lengoctuong2005/cpu4-custom-architecture/Thiết-kế-vi-mạch-điện-tử-Exercises.pdf

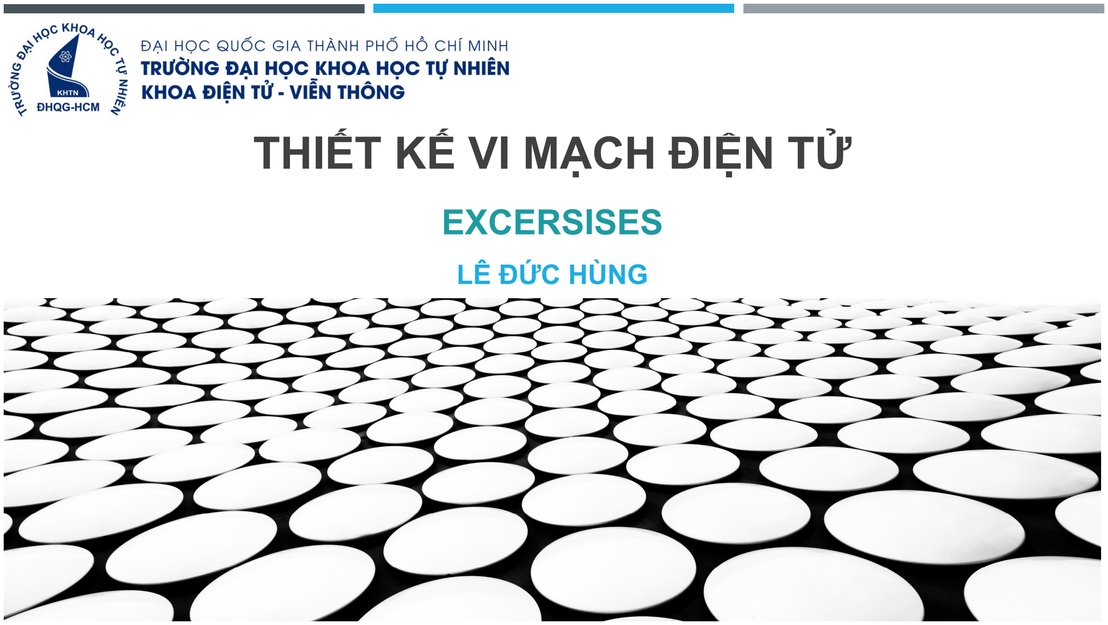
[picture p1: page 1]

# THIẾT KẾ VI MẠCH ĐIỆN TỬ

### LÊ ĐỨC HÙNG

## EXCERSISES

## EXERCISES

1. Find xp, xn, xd, ψ0, Cj0, Cj for an applied voltage of -4V of a pn diode with a step junction, NA = 5x10¹⁵/cm³, ND = 10²⁰/cm³, and an area of 10µm by 10µm.
2. NA = 5x10¹⁵/cm³, ND = 10²⁰/cm³, DN = 20cm²/s, DP = 10cm²/s, LN = 10µm, LP = 5µm, A = 10µm². Calculate the saturation current of pn junction.
3. Using LTSPICE, sketch ID-VDS characteristic of NMOS and PMOS (VGS steps from 1V, 2V, 3V, 4V, 5V) for each following transistor sizes: W/L = 10µm/10µm, W/L = 10µm/1µm, W/L = 1µm/10µm, W/L = 1µm/1µm.
4. Using LTSPICE, sketch ID-VGS characteristic of NMOS and PMOS (VDS steps from 1V, 2V, 3V, 4V, 5V) for each following transistor sizes: W/L = 10µm/10µm, W/L = 10µm/1µm, W/L = 1µm/10µm, W/L = 1µm/1µm.
5. Using LTSPICE, sketch RON-VGS characteristic of NMOS and PMOS with the following transistor sizes: W/L = 50µm/1µm, W/L = 10µm/1µm, W/L = 5µm/1µm, W/L = 1µm/1µm.

2

## EXERCISES

6. Consider an NMOS process technology for which Lmin = 0.4mm, tox = 8nm, mn = 450cm²/Vs, Vt = 0.7V.
a) Find Cox and k’

n.
b) For a MOSFET with W/L = 8mm/0.8mm, calculate the values of vOV, vGS, and vDSmin needed to operate the transistor in the saturation region with dc current ID = 100mA.
c) For the device in (b), find the values of vOV and vGS required to cause the device to operate as a 1kΩ resistor for very small vDS.
7. Consider an NMOS transistor fabricated in an 0.18µm process with L = 0.18µm and W = 2µm. The process technology is specified to have Cox = 8.6fF/µm², mn = 450cm²/Vs, and Vtn = 0.5V.
a) Find VGS and VDS that result in the MOSFET operating at the edge of saturation with ID = 100µA.
b) If VGS is kept constant, find VDS that results in ID = 50µA.
c) To investigate the use of the MOSFET as a linear amplifier, let it be operating in saturation with VDS = 0.3V. Find the change in i

D resulting from vGS changing from 0.7V by +0.01V and -0.01V.

3

## EXERCISES

8. An inverter is designed with (W/L)n = 10 and (W/L)p = 16, which is fabricated in a process where K’n = 110µA/V², VT0n = 0.7V, K’p = 50µA/V², VT0p = -0.7V.
a) Calculate the middle point voltage of the inverter VI

, VIH, VIL. Make sure that VIL < VI < VIH. Use LTSPICE to sketch Vin-Vout function waveform, and Voltage Transfer Characteristic (VTC) curve.
b) Adjust (W/L)n and (W/L)p so that the the middle point voltage is at the center of VTC. Use LTSPICE to sketch Vin-Vout function waveform, and Voltage Transfer Characteristic (VTC) curve.

### 9. Calculate the middle point voltage VI

, of NAND-2 and NOR-2 with (W/L)n = 5 and (W/L)p = 8, which is fabricated in a process where K’n = 110µA/V², VT0n = 0.7V, K’p = 50µA/V², VT0p = -0.7V. Use LTSPICE to sketch Voltage Transfer Characteristic (VTC) curve of NAND2 and NOR2.

4

## EXERCISES

10. Calculation all of the inverter characteristics with the information provided.

5

PMOS Parameters | NMOS Parameters
L = 1µm, W = 7µm | L = 1µm, W = 5µm
Tn = 0.7V, K’n = 110µA/V² | VTp = -0.8V, K’ V p= 50µA/V²
| Cj0 = 4.85x10⁻⁸F/cm² Cj0 = 2.82x10⁻⁸F/cm², φo = 0.9V , φo = 0.92V
| Cjsw = 1.95x10 Cjsw = 4.62x10⁻¹²F/cm, φosw = 0.95V -12F/cm, φosw = 0.97V
Oxide thickness: tox = 150 Amstrong Gate overlap: L0 = 0.05µm
Power supply: VDD = 5V
Fanout number: FO = 3

## EXERCISES

11. Calculation of setup time and hold time. Are there any violations of Setup time and Hold time?

6

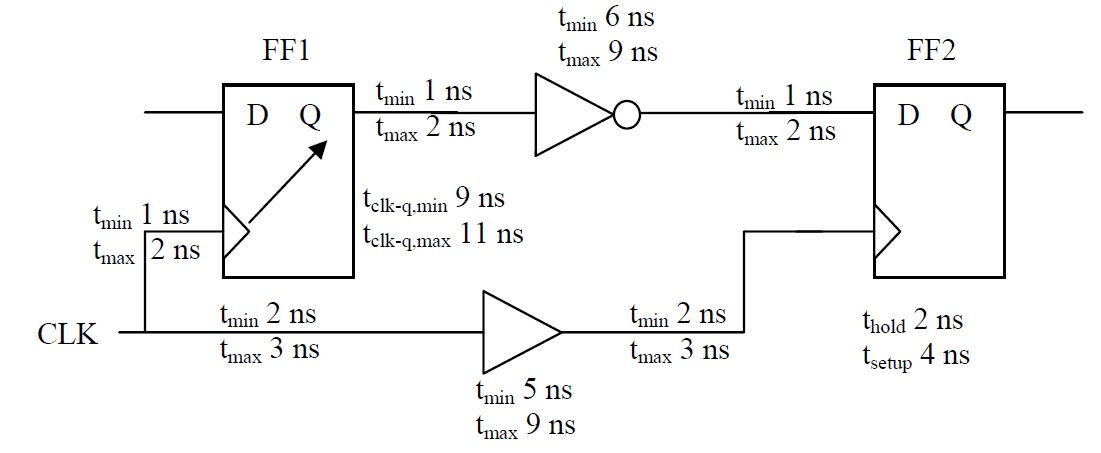
[picture p2: figure]
