lengoctuong2005/cpu4-custom-architecture/docs/CPU_4Bit_Presentation.pptx

THIẾT KẾ CPU 4-BIT

Dùng Quy trình Thiết kế Mạch số (RTL Flow)

Báo cáo Đồ án Môn học: Thiết kế Vi mạch Điện tử
Đề tài số 7 — Mô phỏng kiểm thử RTL (Verilog)

## Slide 2

1. Tổng quan Kiến trúc CPU 4-bit

Đặc tả Kiến trúc (Specifications):

• Kiến trúc Harvard: ROM (Chỉ lệnh) & RAM (Dữ liệu) tách biệt.
• Chu kỳ Đơn (Single-cycle): Mỗi lệnh thực thi hoàn tất trong đúng 1 chu kỳ xung clock.
• Lõi dữ liệu 4-bit: Độ rộng thanh ghi, ALU và RAM dữ liệu là 4-bit.
• Từ lệnh 8-bit: Opcode 4-bit + Toán hạng 4-bit.
• Tập thanh ghi: 4 thanh ghi đa năng R0–R3 (4-bit). R0 dùng làm accumulator cho LOAD/STORE.

Mô hình Lập trình & Tài nguyên:

• Program Counter (PC): 4-bit, trỏ đến 16 địa chỉ ô nhớ ROM.

• Bộ nhớ ROM chỉ lệnh: Kích thước 16 x 8-bit.

• Bộ nhớ RAM dữ liệu: Kích thước 16 x 4-bit.

• Các cờ trạng thái ALU: Cờ Zero (Z) báo kết quả bằng 0; cờ Negative (N) báo kết quả âm.

## Slide 3

2. Tập lệnh (Instruction Set Architecture - ISA)

Từ lệnh 8-bit được chia thành: Opcode [7:4] (4-bit) và Operand [3:0] (4-bit).

Lệnh | Mã máy (Bin) | Toán hạng | Mô tả chức năng
LOAD addr | 0001 | addr (4-bit) | Nạp giá trị từ RAM[addr] vào thanh ghi tích lũy R0
STORE addr | 0010 | addr (4-bit) | Lưu giá trị từ thanh ghi R0 vào RAM[addr]
ADD Rd, Rs | 0011 | Rd (2-bit), Rs (2-bit) | Cộng thanh ghi: R[Rd] = R[Rd] + R[Rs]
SUB Rd, Rs | 0100 | Rd (2-bit), Rs (2-bit) | Trừ thanh ghi: R[Rd] = R[Rd] - R[Rs]
MOV Rd, Rs | 0101 | Rd (2-bit), Rs (2-bit) | Copy dữ liệu: R[Rd] = R[Rs]
JMP addr | 0110 | addr (4-bit) | Nhảy không điều kiện: PC = addr
JZ addr | 0111 | addr (4-bit) | Nhảy nếu cờ Zero bật (Z=1): PC = addr
OUT Rs | 1000 | Rs (2-bit) | Xuất giá trị của thanh ghi Rs ra cổng OUT
HALT | 1111 | Không có | Dừng chương trình (đóng băng PC)

## Slide 4

3. Thiết kế Datapath (Đường đi dữ liệu)

Program Counter

Trỏ địa chỉ lệnh (4-bit)

Instruction ROM

Chứa chương trình (8-bit)

Register File

4 thanh ghi R0-R3 (4-bit)

ALU 4-bit

Cộng, trừ & tính cờ Z, N

Data Memory

RAM lưu dữ liệu (16x4)

Cổng OUT

Mạch thiết kế theo mô hình Single-cycle: trong 1 chu kỳ xung clock, lệnh được nạp từ ROM, giải mã tại Control Unit, đọc dữ liệu từ thanh ghi, tính toán qua ALU, ghi ngược lại thanh ghi hoặc RAM, và PC tăng lên 1.

## Slide 5

4. Khối điều khiển (Control Unit)

Lệnh | RegWr | ALUSrc | ALUOp | MemRd | MemWr | MemToReg
LOAD | 1 | 1 (Mem) | 000 (Pass) | 1 | 0 | 1 (Mem)
STORE | 0 | 1 (Mem) | 000 (Pass) | 0 | 1 | x
ADD | 1 | 0 (Reg) | 001 (Add) | 0 | 0 | 0 (ALU)
SUB | 1 | 0 (Reg) | 010 (Sub) | 0 | 0 | 0 (ALU)
MOV | 1 | 0 (Reg) | 011 (Mov) | 0 | 0 | 0 (ALU)
JMP / JZ | 0 | x | xxx | 0 | 0 | x
OUT | 0 | 0 | 011 (Pass) | 0 | 0 | x

Nhiệm vụ của CU:

• Giải mã Opcode: Nhận 4 bit cao của lệnh [7:4] đưa vào mạch giải mã tổ hợp.

• Sinh tín hiệu điều khiển: Sinh các tín hiệu chọn đường multiplexer, cho phép ghi RAM (mem_write), ghi thanh ghi (reg_write).

• Điều khiển rẽ nhánh: Phối hợp với cờ Z từ ALU để sinh tín hiệu nhảy PC (pc_src).

## Slide 6

5. Kết quả mô phỏng trên Icarus Verilog

Chương trình kiểm thử (Program.mem):

Chương trình thực hiện phép tính:
Cộng hai số tại RAM[10] = 5 và RAM[11] = 7. Kết quả ghi vào RAM[12].

0x0: LOAD 10 ; R0 = RAM[10] (5)
0x1: MOV R1, R0 ; R1 = R0 (5)
0x2: LOAD 11 ; R0 = RAM[11] (7)
0x3: ADD R1, R0 ; R1 = R1 + R0 (12)
0x4: MOV R0, R1 ; R0 = R1 (12)
0x5: STORE 12 ; RAM[12] = R0 (12)
0x6: OUT R0 ; OUT = 12 (0xC)
0x7: HALT ; Dừng chương trình

Kết quả mô phỏng (Simulation Output):

Biên dịch & mô phỏng thành công trên Icarus Verilog v12:

[TIME: 10] Reset released
[TIME: 30] PC: 0, Instruction: 1A (LOAD 10) -> R0: 5
[TIME: 50] PC: 1, Instruction: 54 (MOV R1,R0) -> R1: 5
[TIME: 70] PC: 2, Instruction: 1B (LOAD 11) -> R0: 7
[TIME: 90] PC: 3, Instruction: 34 (ADD R1,R0) -> R1: 12
[TIME: 130] PC: 5, Instruction: 2C (STORE 12) -> RAM[12]: 12
[TIME: 150] PC: 6, Instruction: 80 (OUT R0) -> Cổng OUT: 12

=> Đạt yêu cầu: Giá trị tại RAM[12] ghi nhận đúng 12 (0xC), cổng OUT xuất đúng giá trị 12, chương trình kết thúc tại lệnh HALT.

## Slide 7

KẾT LUẬN & ĐÁNH GIÁ ĐỒ ÁN

• Hoàn thành thiết kế mức RTL: Đã thiết kế toàn bộ các khối chức năng bằng ngôn ngữ Verilog chuẩn tắc.
• Khắc phục lỗi zero-delay loop: Đã sửa thành công lỗi phản hồi vòng kín tại thời điểm khởi tạo trong Control Unit.
• Kiểm tra đúng chức năng: Chương trình chạy chính xác trên bộ mô phỏng Icarus Verilog và xuất kết quả đúng dạng sóng.
• Hướng phát triển: Tích hợp thêm bộ giải mã hiển thị LED 7 thanh hoặc thực hiện tổng hợp mạch (Synthesis) mức cổng.
