lengoctuong2005/cpu4-custom-architecture/docs/CPU_4Bit_Presentation_Premium.pptx

ĐỒ ÁN MÔN HỌC THIẾT KẾ VI MẠCH ĐIỆN TỬ

Thiết Kế CPU 4-Bit
Dùng Quy Trình RTL Flow

Quy trình thiết kế mạch số trên ngôn ngữ Verilog | Mô phỏng kiểm thử chuyên sâu

Học kỳ 3 (2025-2026) | Topic số 7

## Slide 2

TỔNG QUAN ĐỀ TÀI

Đặc Tả Kiến Trúc CPU 4-Bit

Kiến trúc Harvard

Bộ nhớ dữ liệu (RAM) và Bộ nhớ chỉ lệnh (ROM) được tách biệt hoàn toàn về đường truyền vật lý.
Cho phép nạp lệnh từ ROM và đọc/ghi RAM dữ liệu trong cùng một thời điểm mà không xảy ra xung đột bus.

Single-Cycle Core

Mỗi chu kỳ xung nhịp (clock edge) thực thi hoàn chỉnh đúng một lệnh.
Đơn giản hóa khối điều khiển điều hướng, tối ưu hóa quá trình kiểm tra chức năng logic của mạch xử lý.

Lõi Dữ Liệu 4-bit

Các thanh ghi đa năng R0-R3 có độ rộng 4-bit.
ALU tính toán toán số học/logic trên dữ liệu 4-bit.
Tập lệnh tối giản với độ rộng từ lệnh cố định 8-bit (Opcode 4-bit + Operand 4-bit).

01

02

03

## Slide 3

KIẾN TRÚC TẬP LỆNH

Định Dạng Chỉ Lệnh & Tập Lệnh Tối Giản

Lệnh (ASM) | Opcode | Chức năng thực thi
LOAD addr | 0001 | Nạp dữ liệu từ RAM[addr] vào R0
STORE addr | 0010 | Lưu dữ liệu từ R0 vào RAM[addr]
ADD Rd, Rs | 0011 | Cộng thanh ghi: R[Rd] = R[Rd] + R[Rs]
SUB Rd, Rs | 0100 | Trừ thanh ghi: R[Rd] = R[Rd] - R[Rs]
MOV Rd, Rs | 0101 | Sao chép dữ liệu giữa các thanh ghi
JMP addr | 0110 | Nhảy không điều kiện tới địa chỉ ROM
JZ addr | 0111 | Nhảy nếu cờ Zero Z = 1
OUT Rs | 1000 | Xuất giá trị của Rs ra cổng ngoài
HALT | 1111 | Dừng chạy chương trình

ĐỊNH DẠNG TỪ LỆNH (8-BIT)

Opcode (4-bit): Định nghĩa 9 phép toán xử lý cơ bản.
Operand (4-bit): Chứa địa chỉ bộ nhớ (RAM/ROM) hoặc chỉ số của tập thanh ghi nguồn/đích.

OPCODE
[7:4]

OPERAND
[3:0]

## Slide 4

SƠ ĐỒ KIẾN TRÚC

Đường Đi Dữ Liệu (Datapath) Tối Ưu

Program Counter

Tăng địa chỉ PC qua từng cạnh clock

Instruction Memory

ROM nạp mã máy 8-bit tương ứng

Register File

Lấy dữ liệu từ R0-R3 cho toán hạng

FETCH

DECODE

REG READ

Data Memory (RAM)

Đọc/ghi kết quả tính toán vào RAM

WRITEBACK

ALU 4-bit

Thực hiện ADD/SUB/Pass qua opcode

EXECUTE

## Slide 5

KHỐI ĐIỀU KHIỂN

Logic Giải Mã Trực Quan (Control Unit)

Opcode | Lệnh | RegWrite | ALUSrc | ALUOp | MemWrite | MemtoReg
0001 | LOAD | 1 | 1 (Mem) | 000 (Pass) | 0 | 1 (Mem)
0010 | STORE | 0 | 1 (Mem) | 000 (Pass) | 1 | x
0011 | ADD | 1 | 0 (Reg) | 001 (Add) | 0 | 0 (ALU)
0100 | SUB | 1 | 0 (Reg) | 010 (Sub) | 0 | 0 (ALU)
0101 | MOV | 1 | 0 (Reg) | 011 (Pass) | 0 | 0 (ALU)
0110 | JMP | 0 | x | xxx | 0 | x
0111 | JZ | 0 | x | xxx | 0 | x
1000 | OUT | 0 | 0 (Reg) | 011 (Pass) | 0 | x
1111 | HALT | 0 | x | xxx | 0 | x

GIẢI MÃ LỆNH TỔ HỢP

Control Unit đóng vai trò bộ não của CPU:

• Mạch Tổ Hợp: Nhận opcode 4-bit đầu vào và chuyển đổi tức thời sang các tín hiệu điều khiển mà không tốn chu kỳ clock.

• Tránh Vòng Phản Hồi: Cấu trúc độc lập của cờ Z và N tách rời khỏi tổ hợp khối điều khiển giúp mạch mô phỏng tránh được lỗi zero-delay loop.

## Slide 6

KIỂM THỬ ĐỒ ÁN

Kiểm Thử Chương Trình & Kết Quả Mô Phỏng

TERMINAL - CODE MÃ MÁY (PROG.MEM)

1A ; PC=0 | LOAD RAM[10] -> R0 (5)
54 ; PC=1 | MOV R1, R0 -> R1 (5)
1B ; PC=2 | LOAD RAM[11] -> R0 (7)
34 ; PC=3 | ADD R1, R0 -> R1 (12)
50 ; PC=4 | MOV R0, R1 -> R0 (12)
2C ; PC=5 | STORE R0 -> RAM[12]
80 ; PC=6 | OUT R0 -> OUT=12
F0 ; PC=7 | HALT -> STOP

TRÌNH TỰ MÔ PHỎNG (WAVEFORM LOG)

Reset (rst_n) được kích hoạt lên mức 1, CPU bắt đầu hoạt động.

PC=0, đọc lệnh 1A: Nạp giá trị 5 từ RAM[10] vào R0 thành công.

PC=3, lệnh 34: Thực hiện R1 = R1 (5) + R0 (7). Kết quả R1 = 12.

PC=5, lệnh 2C: Ghi giá trị 12 từ R0 vào ô nhớ RAM[12].

PC=6, lệnh OUT: Giá trị 12 xuất ra cổng ngoài. Nhận tín hiệu HALT dừng máy.

t = 10ns

t = 30ns

t = 90ns

t = 130ns

t = 150ns

## Slide 7

TỔNG KẾT ĐỒ ÁN

Kết Luận & Hướng Phát Triển Đề Tài

CHẤT LƯỢNG MÔ PHỎNG

100%

Các chức năng tính toán số học, rẽ nhánh điều kiện và ghi dữ liệu bộ nhớ đều đạt độ chính xác hoàn đối đối chứng trực tiếp qua giản đồ xung sóng (waveform).

Hoàn thiện RTL Flow

Thiết kế thành công toàn bộ kiến trúc lõi CPU bằng Verilog chuẩn hóa.

Sửa lỗi treo Simulator

Loại bỏ hoàn toàn combinational feedback loop tại Control Unit giúp mạch chạy ổn định.

Hướng phát triển tương lai

Mở rộng tập lệnh lên 16-bit, bổ sung bộ nhân chuyên dụng (multiplier) và tổng hợp ASIC.
