lengoctuong2005/cpu4-custom-architecture/docs/assets/anhGDS.jpg

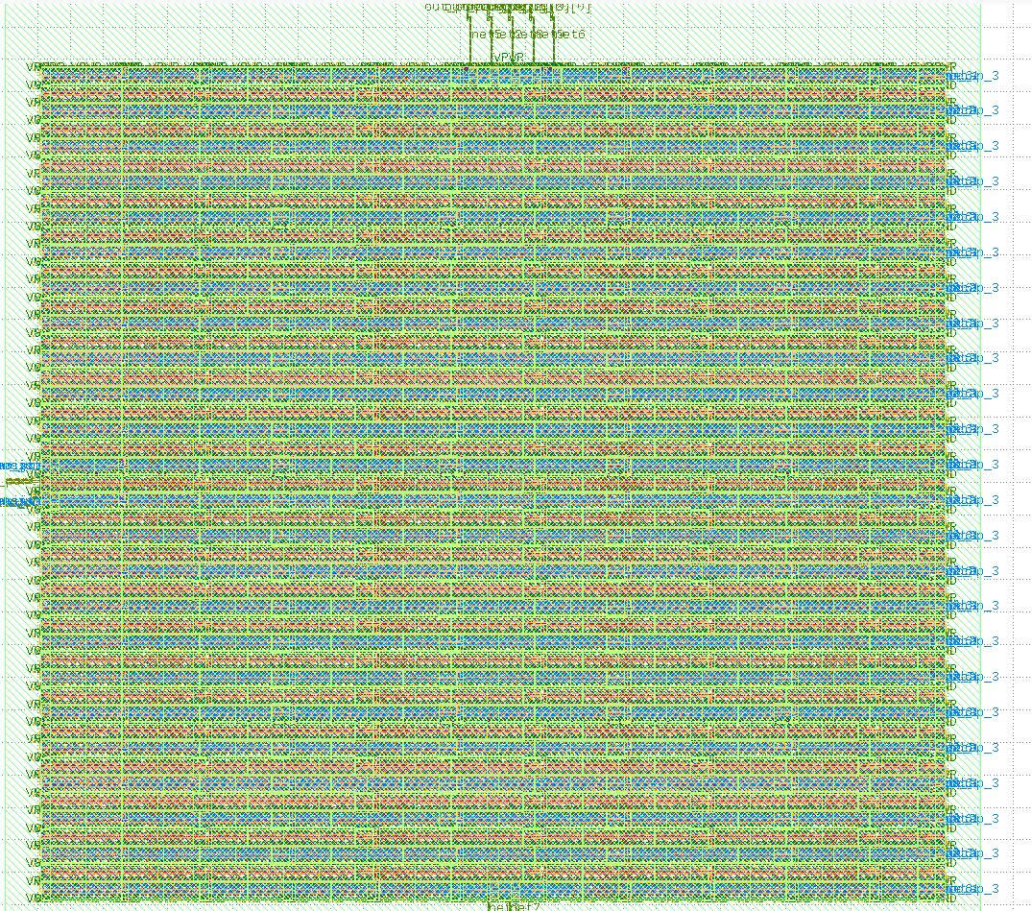
docs/assets/anhGDS.jpg
