lengoctuong2005/cpu4-custom-architecture/docs/assets/khoi2.png

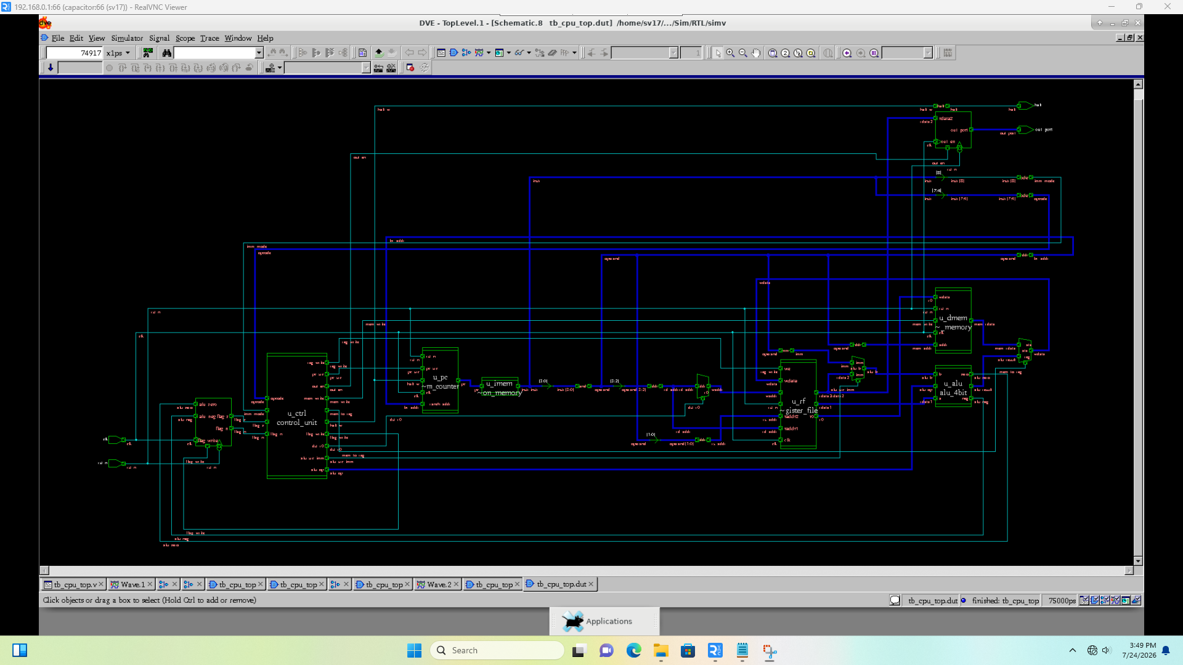
docs/assets/khoi2.png
