lengoctuong2005/cpu4-custom-architecture/docs/assets/khoi.png

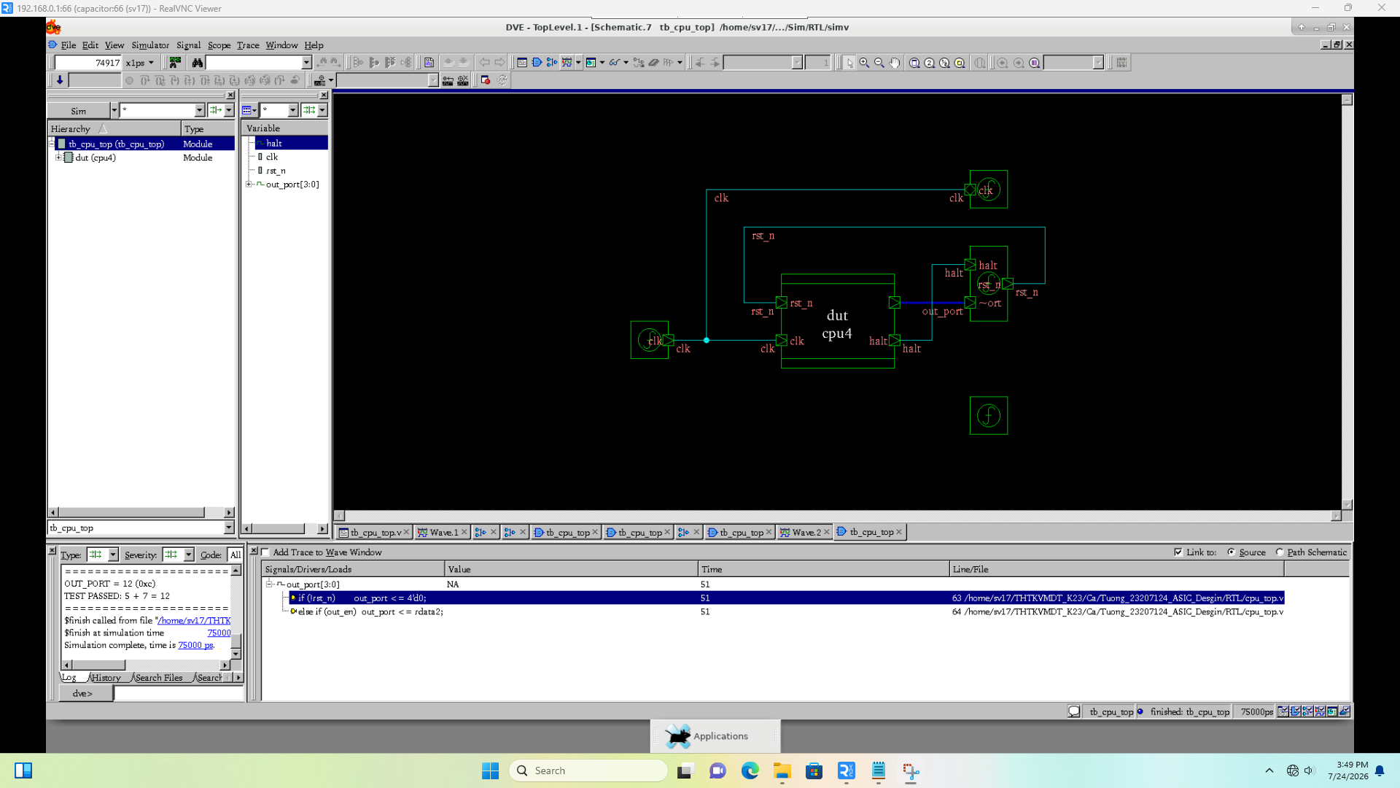
docs/assets/khoi.png
