lengoctuong2005/cpu4-custom-architecture/(commit log)

2026-07-17 Thêm toàn bộ file dự án
2026-07-17 test: Consolidate testbench and fix FIB OUT capture race condition
    - Remove stale rtl/tb_cpu.sv to ensure single canonical testbench.
    - Fix nonblocking assignment race in tb_cpu_top.v by sampling out_port using delayed prev_opcode.
    - Verify 3/3 PASS for ADD, MUL, and FIB sequence.
    [tb_cpu_top.v]
2026-07-17 build: Fix SystemVerilog compilation, Windows build commands, and add schematic SVG
2026-07-19 fix+docs: correct ALU testbench, honest reporting, cross-platform Makefile, real README
    Testbench (real bug fix):
    - tb/tb_alu_4bit.v asserted carry==1 for SUB/DEC borrow cases, contradicting
    the documented convention (borrow => carry=0). Corrected those checks,
    added Z/N/C coverage for all ops, and made the summary count failures
    instead of always printing 'passed'.
    Tooling & docs (consistency / polish):
    - Makefile: cross-platform 'clean'; add 'alu', 'test', 'asm', 'pysim' targets.
    - README.md: replace empty/garbled file with full project overview.
    - docs/isa.md: fix instruction-format diagram and 'hợp dịch' typo.
    - docs/setup.md: prog.hex is 9-bit (3 hex chars), not '1 byte'.
    - s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
    [tb_alu_4bit.v]
2026-07-19 chore: remove accidentally-committed .agents framework and build artifacts
    - Remove .agents/ (2609 files, ~35MB AI coding-agent scaffold pushed by mistake)
    - Untrack node_modules/, .manifest_cache.json and simulation outputs
    (*.vcd/*.vvp/*.out, sim/_debug.txt) — regenerable, not source
    - Remove unused root-level duplicate data.mem / prog.mem
    - Expand .gitignore: node_modules/, __pycache__/, .manifest_cache.json
2026-07-20 fix: correct RTL flags, optimize mul.asm algorithm, and update documentation
    - Implement always_comb in control_unit.v and rename zero/negative inputs to flag_zero_in/flag_neg_in.
    - Remove Carry flag from documentation (docs/isa.md, README.md) to match RTL behavior.
    - Optimize mul.asm to check A=0 (AND R1, R1) before entering the loop to avoid wrap-around, fitting within 16 ROM words.
    - Update Bao_cao_CPU_4bit.md/html and slides to remove GDSII physical layout claims and adjust toolchain info.
    - Update AGENTS.md to match the active testbench (tb/tb_cpu_top.v) and .gitignore setup.
    [control_unit.v, cpu_top.v]
2026-09-28 feat(asic): complete Synopsys 32nm ASIC implementation suite, FPGA wrappers, and publication-grade documentation
    - Synthesizable Verilog RTL for 4-bit Harvard microprocessor with 4x4 register file
    - Synopsys Design Compiler logic synthesis script (SAED 32nm PDK) and SDC timing constraints
    - Synopsys IC Compiler II physical design (PnR) scripts and power distribution
    - Synopsys Formality logic equivalence checking (LEC) suites (RTL vs Gate, Post-PnR)
    - Intel Quartus Prime FPGA deployment wrapper for DE10-Lite
    - Custom 2-pass Python assembler and cycle-accurate emulator
    - Comprehensive README documentation with full microarchitecture specs, ISA table, and waveforms
    - Clean .gitignore ignoring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
2026-09-28 docs(readme): polish technical documentation for semiconductor internship portfolio
    - Comprehensive microarchitecture specification and register descriptions
    - Complete 16-instruction ISA reference with bit encodings
    - Detailed Synopsys 32nm ASIC implementation workflow (DC, ICC2, Formality)
    - FPGA prototyping guide for Terasic DE10-Lite
    - Quickstart guide and simulation waveforms
2026-09-28 feat(release): clean up repository, complete Synopsys 32nm ASIC flow, and publish documentation
    - Synopsys Design Compiler synthesis and SDC timing constraints
    - Synopsys IC Compiler II physical design (PnR) scripts and power routing
    - Synopsys Formality logic equivalence checking (LEC) suites
    - Verified assembly test suites (Fibonacci, 4-bit multiplication, flag test)
    - Professional open-source documentation and MIT license
    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
2026-09-28 feat(fpga): add synthesizable 7-segment display decoder for FPGA board
    - Active-low 7-segment hexadecimal decoder for Cyclone V DE10 display
    - Fully synthesizable Verilog-2001
2026-09-30 feat(arch): unify cpu_top architecture, lock ISA v1, and harden verification
    - Standardize top module reference to cpu_top across DC, ICC2, Formality, and FPGA
    - Lock ISA v1 specification (Z/N flags, LDI #imm, JN branch) and deprecate pseudo-ops
    - Fix assembler boundary condition for 16-instruction ROM and add duplicate label check
    - Add 2,048-case exhaustive ALU testbench and submodule unit test suite with $fatal(1)
    - Synchronize registered clock generation in FPGA wrapper to eliminate ripple hazards
    - Add open-source Yosys synthesis target and SAED32nm EDA pre-checks
    - Untrack heavy third-party PDFs from repository index to optimize clone size
    [cpu4_de10.v, cpu_top.v, cpu_top_fpga.v, instruction_memory_rom.v]
